androng/Shift-stairs/README.md

Shift-stairs
============

Code for stair lights controller

The Arduino code is in the pde file.
