androng/Shift-stairs/Stairs Lights/main.brd

## EAGLE design Stairs Lights/main.brd (2015-06-18)

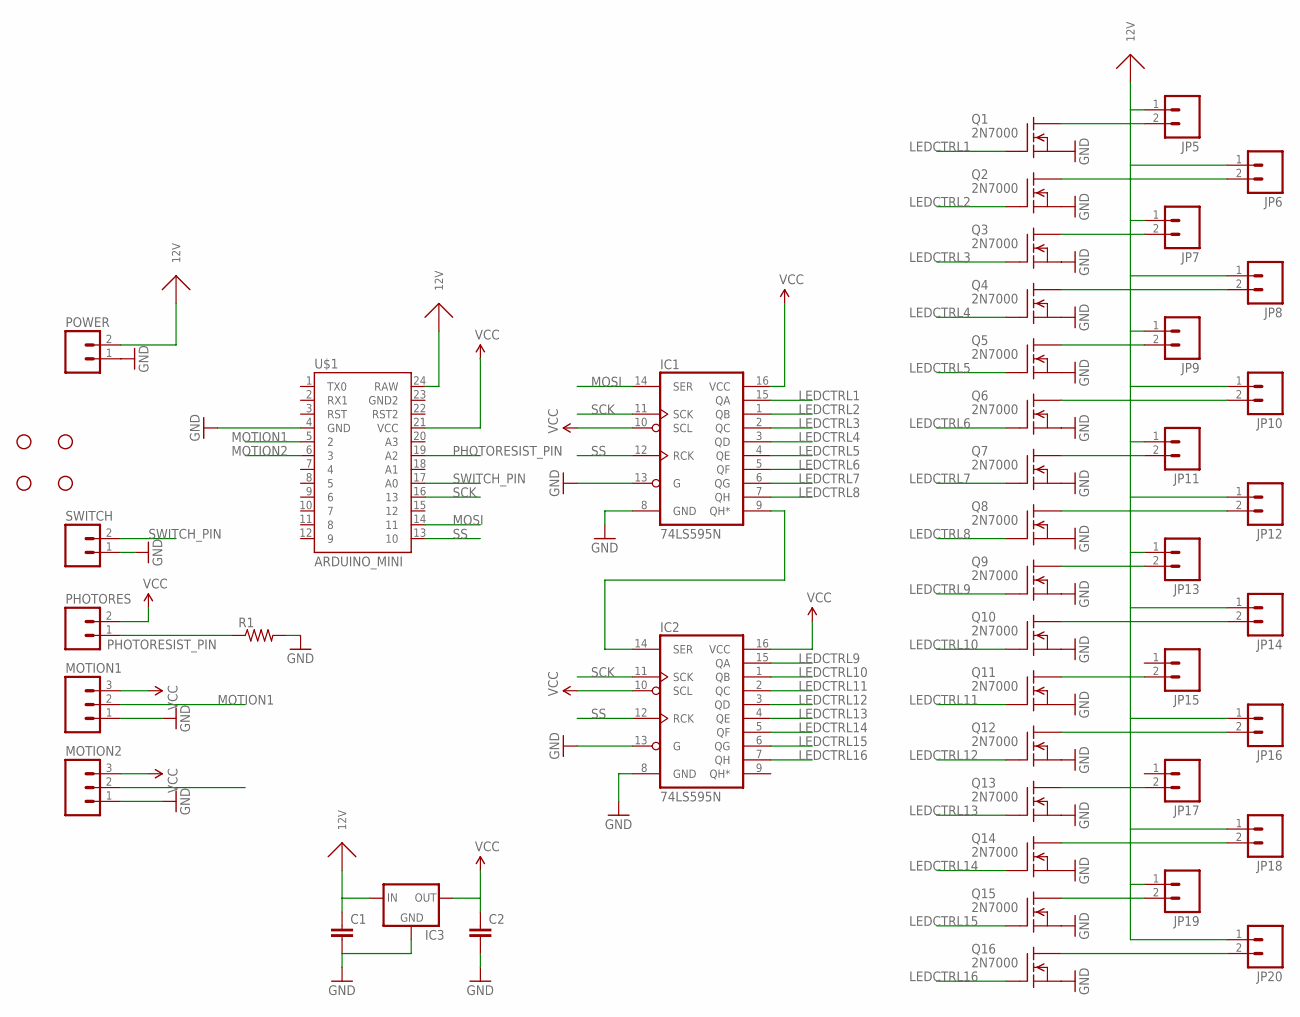
[picture p1: schematic main.sch]

Parts:
C1, C2: CAPKIT; CAP-PTH-SMALL-KIT
IC1, IC2: 74LS595N; DIL16
IC3: V_REG_78XXSINK; TO220-IGO
JP1, JP2, JP3, JP4: STAND-OFF
JP5, JP6, JP7, JP8, JP9, JP10, JP11, JP12, JP13, JP14, JP15, JP16, JP17, JP18, JP19, JP20: M02PTH; 1X02
MOTION1, MOTION2: M03PTH; 1X03
PHOTORES: M02PTH; 1X02
POWER: M025MM; SCREWTERMINAL-5MM-2
Q1, Q2, Q3, Q4, Q5, Q6, Q7, Q8, Q9, Q10, Q11, Q12, Q13, Q14, Q15, Q16: 2N7000; TO92
R1: RESISTORAXIAL-0.3; AXIAL-0.3
SWITCH: M02PTH; 1X02
U$1: ARDUINO_MINI

Connections:
12V: C1.1, IC3.IN, JP5.1, JP6.1, JP7.1, JP8.1, JP9.1, JP10.1, JP11.1, JP12.1, JP13.1, JP14.1, JP16.1, JP18.1, JP19.1, JP20.1, POWER.2, U$1.24 (RAW)
GND: C1.2, C2.2, IC1.8 (GND), IC1.13 (G), IC2.8 (GND), IC2.13 (G), IC3.GND, MOTION1.1, MOTION2.1, POWER.1, Q1.1 (S), Q2.1 (S), Q3.1 (S), Q4.1 (S), Q5.1 (S), Q6.1 (S), Q7.1 (S), Q8.1 (S), Q9.1 (S), Q10.1 (S), Q11.1 (S), Q12.1 (S), Q13.1 (S), Q14.1 (S), Q15.1 (S), Q16.1 (S), R1.P$2 (2), SWITCH.1, U$1.4 (GND)
LEDCTRL1: IC1.15 (QA), Q1.2 (G)
LEDCTRL2: IC1.1 (QB), Q2.2 (G)
LEDCTRL3: IC1.2 (QC), Q3.2 (G)
LEDCTRL4: IC1.3 (QD), Q4.2 (G)
LEDCTRL5: IC1.4 (QE), Q5.2 (G)
LEDCTRL6: IC1.5 (QF), Q6.2 (G)
LEDCTRL7: IC1.6 (QG), Q7.2 (G)
LEDCTRL8: IC1.7 (QH), Q8.2 (G)
LEDCTRL9: IC2.15 (QA), Q9.2 (G)
LEDCTRL10: IC2.1 (QB), Q10.2 (G)
LEDCTRL11: IC2.2 (QC), Q11.2 (G)
LEDCTRL12: IC2.3 (QD), Q12.2 (G)
LEDCTRL13: IC2.4 (QE), Q13.2 (G)
LEDCTRL14: IC2.5 (QF), Q14.2 (G)
LEDCTRL15: IC2.6 (QG), Q15.2 (G)
LEDCTRL16: IC2.7 (QH), Q16.2 (G)
MOSI: IC1.14 (SER), U$1.14 (11)
MOTION1: MOTION1.2, U$1.5 (2)
MOTION2: MOTION2.2, U$1.6 (3)
unnamed: IC1.9 (QH*), IC2.14 (SER)
unnamed: JP5.2, Q1.3 (D)
unnamed: JP6.2, Q2.3 (D)
unnamed: JP7.2, Q3.3 (D)
unnamed: JP8.2, Q4.3 (D)
unnamed: JP9.2, Q5.3 (D)
unnamed: JP10.2, Q6.3 (D)
unnamed: JP11.2, Q7.3 (D)
unnamed: JP12.2, Q8.3 (D)
unnamed: JP13.2, Q9.3 (D)
unnamed: JP14.2, Q10.3 (D)
unnamed: JP15.2, Q11.3 (D)
unnamed: JP16.2, Q12.3 (D)
unnamed: JP17.2, Q13.3 (D)
unnamed: JP18.2, Q14.3 (D)
unnamed: JP20.2, Q16.3 (D)
unnamed: JP19.2, Q15.3 (D)
PHOTORESIST_PIN: PHOTORES.1, R1.P$1 (1), U$1.19 (A2)
SCK: IC1.11 (SCK), IC2.11 (SCK), U$1.16 (13)
SS: IC1.12 (RCK), IC2.12 (RCK), U$1.13 (10)
SWITCH_PIN: SWITCH.2, U$1.17 (A0)
VCC: C2.1, IC1.10 (SCL), IC1.16 (VCC), IC2.10 (SCL), IC2.16 (VCC), IC3.OUT, MOTION1.3, MOTION2.3, PHOTORES.2, U$1.21 (VCC)

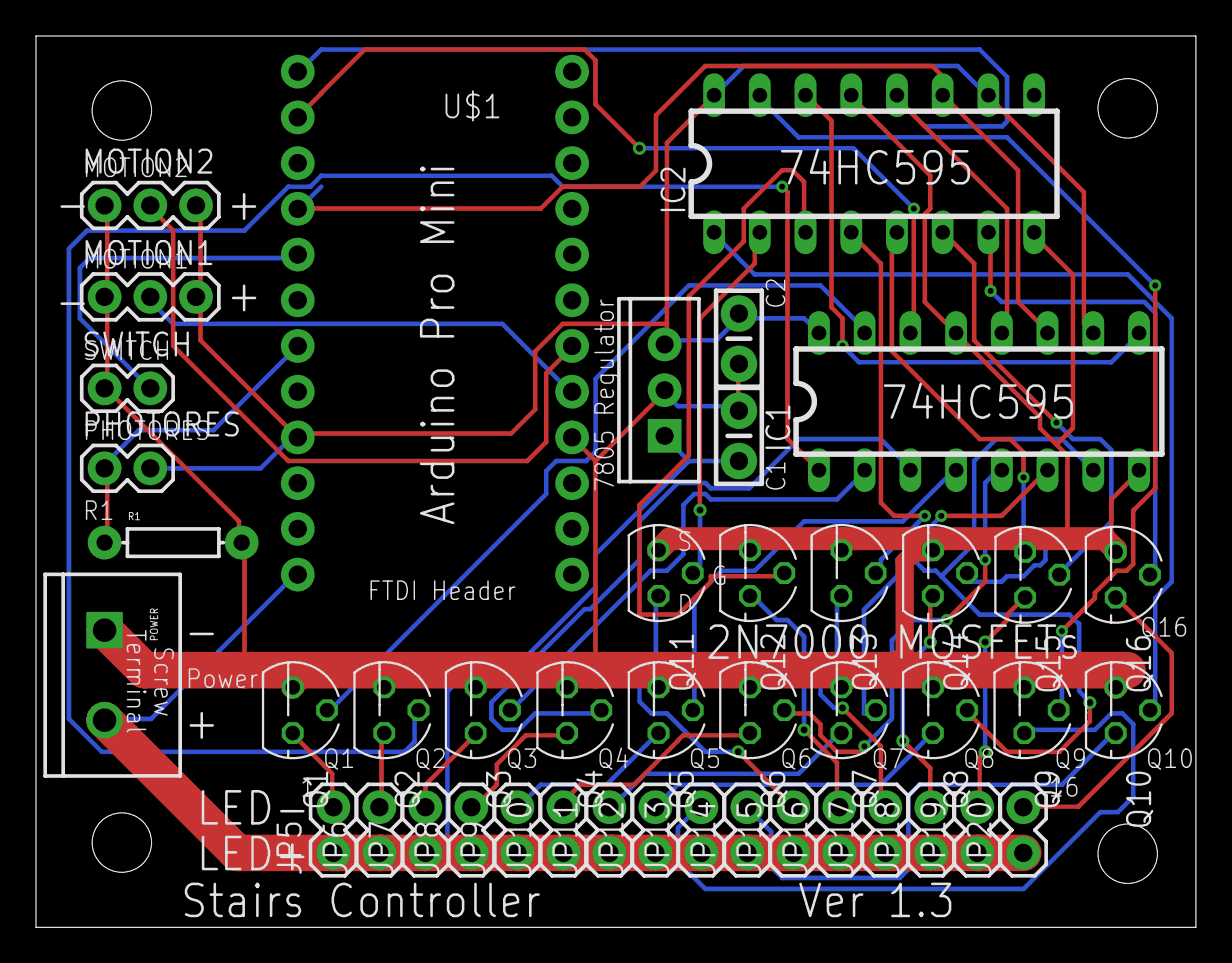
[picture p2: board main.brd from above]

Board: 2 copper layers, 64.4 x 49.5 mm, 48 parts (0 on the bottom side), 43 nets.
