androng/Shift-stairs/(commit log)

2011-08-24 Switch override added in software. No interrupts.
2011-08-24 Shortened turnon/off duration, added motion sensor interrupt turn on/off.
2011-08-25 Added photoresistor support so that the circuit will not turn on when it is bright.
2013-07-29 Added Eagle Board Files
    [main.brd, main.sch]
2014-11-10 Changed PCB to V1.1, fixed backwards transistor problem
    [main.brd, main.sch]
2015-02-09 Updated to version 1.2
    [main.brd, main.sch]
2015-06-16 1.3 Fixed photoresistor hardware problem
    [main.brd, main.sch]
2015-06-18 Changed some layers in 1.3
    [main.brd]
